caoyuan96421/automatic_exfoliation/Automatic_Exfoliation/PCB/Readme.txt

Please use 3rd party softwares for visualizing Gerber files (the industry standard of PCB files).

A good choice is open source gerbv (http://gerbv.sourceforge.net/)
