caoyuan96421/automatic_exfoliation/Automatic_Exfoliation/Bill_Of_Materials.xlsx

Part name | Count | Part number | Cost/each | in-line total | Supplier | Comments
ATMega328 | 1 | ATMEGA328-PU-ND | $3.41 | $3.41 | Digikey
16MHz Crystal (SMD) | 1 | XC1282CT-ND | $0.21 | $0.21 | Digikey
IC Socket DIP28 | 1 | ED90054-ND | $1.68 | $1.68 | Digikey
10uF 3216 Tantalum Cap | 2 | 399-3687-1-ND | $0.09 | $0.18 | Digikey
10 pin connector for ISP | 1 | S9169-ND | $0.64 | $0.64 | Digikey | This is used for connecting the programmer
AVR Programmer | 1 | 1188-1008-ND | $27.95 | $27.95 | Digikey | This is used for programming the controller
Limit switch | 1 | SW745-ND, 455-1562-ND and 455-1563-1-ND | $2.58 | $2.58 | Digikey | The parts numbers are for the switch, the connector and the wire crimper
XH-series connector 2-pin | 9 | 455-2247-ND and 455-2266-ND | $0.24 | $2.16 | Digikey | Male pins and female housings
XH-series connector 3-pin | 2 | 455-2248-ND and 455-2266-ND | $0.28 | $0.56 | Digikey | Male pins and female housings
XH-series wire crimper | 50 | 455-1135-1-ND | $0.02 | $1.00 | Digikey
XH-series crimper tool | 1 | http://www.amazon.com/Engineer-PA-21-Universal-Crimping-Pliers/dp/B002L6HJ8W?s=hi | $46.37 | $46.37 | Amazon | The tool is in the toolbox in meas lab, please ask for instructions if you want to use
Header pins, 0.1in pitch | 6 | PRPC040SAAN-RC | $0.74 | $4.44 | Digikey | This is common supply for any type of electronics
Color flat ribbon cable 26AWG, 10' | 1 | MC090M-10-ND | $5.61 | $5.61 | Digikey
Test lead copper wire 18 AWG, 50' | 1 | 501-1281-ND (black), 501-1282-ND (red) | $24.95 | $24.95 | Digikey | Excellent and very flexible copper wire for general purpose
MTA-100 connector | 1 | A30837-ND and A99621-ND | $0.88 | $0.88 | Digikey | Female and male respectively. These connectors are very robust for general purpose hanging connections.
MTA-100 hand tool | 1 | A9982-ND | $39.15 | $39.15 | Digikey | The tool is in the toolbox in meas lab, please ask for instructions if you want to use
Power plug receptacle panel mount | 1 | Q212-ND | $0.78 | $0.78 | Digikey
PC Board | 1 | - | $6.66 | $6.66 | Oshpark | There are two spare boards (minimum order of 3)
0805 SMD resistors and 1/4W resistors | 10 | - | - |  | - | Plenty in meas lab
0805 Capacitors | 10 | - | - |  | - | Plenty in meas lab
Heat shrink tube | 1 | Q53X014B-ND, Q53X018B-ND and Q2F3X116B-ND | $4.38 | $4.38 |  | Diameter 1/4'', 1/8'' and 1/16'' respectively
Power supply, 5V/24V dual output | 1 | 1145-1099-ND | $32.44 | $32.44 | Digikey
Sainsmart CNC stepper motor driver | 1 | ST-M505 | $42.00 | $42.00 | Amazon | one spare in the lab
5-pin piano DIP switches | 1 | SW PIANO DIP SPST 5 POS UNSEALD | $1.31 | $1.31 | Digikey | for replacing the DIP switch in the Stepper motor driver (line item above)
linear potentiometer | 1 | 987-1404-ND | $1.37 | $1.37 | Digikey
4-pin ON-OFF toggle switch | 2 | 360-2091-ND (http://www.digikey.com/product-detail/en/S41/360-2091-ND/1007148) | $9.13 | $18.26 | Digikey | more heavy-duty than necessary
red OFF-MOM pushbutton | 1 | 1091-1041-ND | $1.98 | $1.98 | Digikey
cool red/green LED button | 1 | 708-1451-ND (http://www.digikey.com/product-detail/en/MPI002%2FTERM%2FD1/708-1451-ND/1980808) | $30.43 | $30.43 | Digikey
Mechanical components
T-slotted framing, 3-inch | 1 | 47065T109 (https://www1.mcmaster.com/) | $27.92 | $27.92 | McMaster | 2 feet minimum order
Linear bearings | 2 | 60585K76 (https://www1.mcmaster.com/) | $65.44 | $130.88 | McMaster
Hand break for the bearing | 2 | 60585K32 (https://www1.mcmaster.com/) | $15.50 | $31.00 | McMaster
90 deg Aluminum L-extrusion | 1 | 8982K61 (https://www1.mcmaster.com/) | $15.53 | $15.53 | McMaster | 1 foot minimum order
1/2" aluminum plate |  |  |  |  | lab scrap material | to place sample on
NEMA 17 captive linear stepper, 1.5 micron steps, 2" stroke | 1 | 43K4U-2.33-920 | $156.35 | $156.35 | Haydon-Kerk | 1 spare available
11.5x16" aluminum rack-mountable box | 1 | 12-19123B | $114.00 | $114.00 | Par-Metal
acrylic display case | 1 | STAD-11-15-5 | $33.38 | $33.38 | casesforcollectibles.com
[advanced tape clip TBD]
TOTAL SUM |  |  |  | $810.43
