caoyuan96421/automatic_exfoliation/Automatic_Exfoliation/Mechanical/limit_switch_holder.SLDPRT

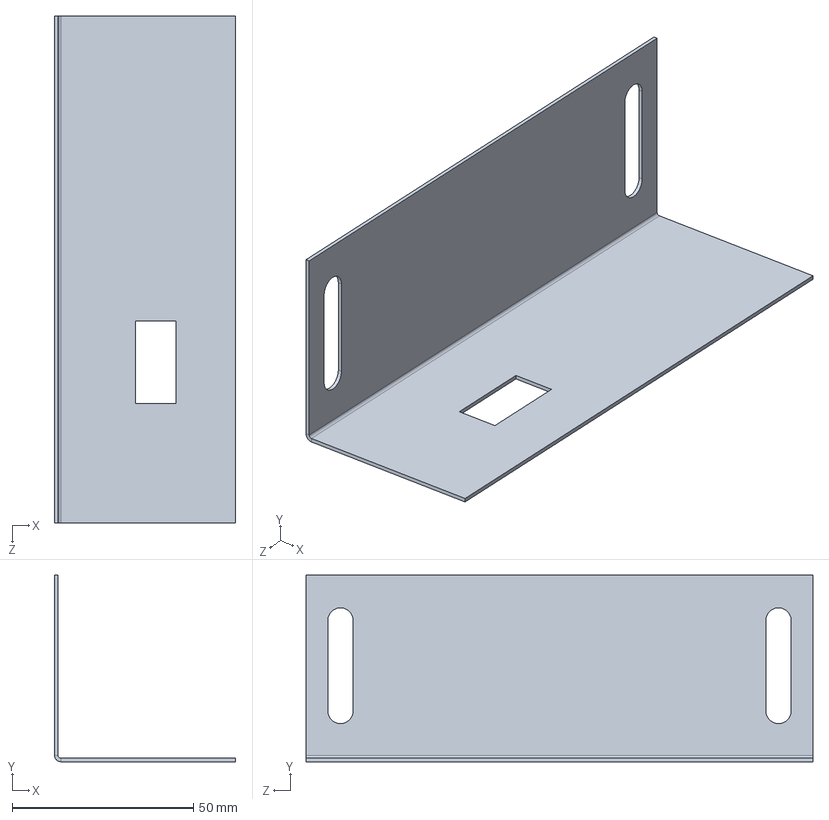
[picture p1: CAD file, 2014-10-27]
Automatic_Exfoliation/Mechanical/limit_switch_holder.SLDPRT
50.0 x 51.5 x 140.0 mm
