caoyuan96421/automatic_exfoliation/(list of files, cad)

Other CAD files:
Automatic_Exfoliation/Mechanical/limit_switch_holder.SLDDRW
