caoyuan96421/automatic_exfoliation/Automatic_Exfoliation/schematic.pdf

U1

## DEBUG

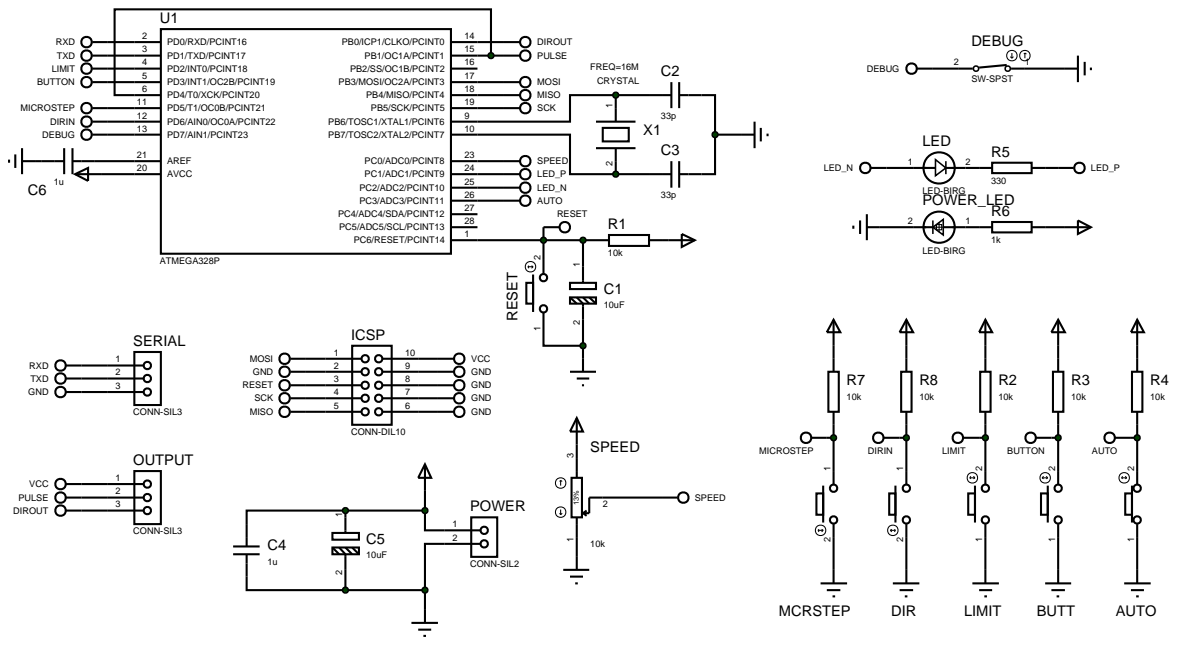
[picture p2: page 1]
