caoyuan96421/automatic_exfoliation/(list of files, drawings)

Other design files:
Automatic_Exfoliation/Simulation/Automatic_Exfoliation.pdsprj
