caoyuan96421/automatic_exfoliation/(commit log)

2014-10-11 Automatic Exfoliation program collection
    [Automatic_Exfoliation.GBL, Automatic_Exfoliation.GBO, Automatic_Exfoliation.GBS, Automatic_Exfoliation.GKO, Automatic_Exfoliation.GTL, Automatic_Exfoliation.GTO, Automatic_Exfoliation.GTS, Automatic_Exfoliation.XLN]
2014-10-12 Added Watch Dog timer
    to prevent system crash
    [Automatic_Exfoliation.c]
2014-10-13 pdf layout and schematic
    [Automatic_Exfoliation.pdsprj]
2014-10-16 Added BOM
    [Bill_Of_Materials.xlsx]
2014-10-17 updated BOM
    added structural and mechanical components, and additional electronic
    components. Added in-line total column and a sum total calculation for
    costs.
    [Bill_Of_Materials.xlsx]
2014-10-26 added limit switch holder Solidworks model
    [limit_switch_holder.SLDPRT]
2014-10-27 Updated solidworks drawing
    [limit_switch_holder.SLDDRW, limit_switch_holder.SLDPRT]
